circuz/TIFX11-FYP415-VT24-17/README.md

# TIFX11-FYP415-VT24-17
GitHub repository for bachelors thesis in physics on the collective behaviour of autonomous robots in a complex environment

# Required packages:
apriltag
cv2
pandas
numpy
pyqtgraph
