circuz/TIFX11-FYP415-VT24-17/3d_models/whole_robot.FCStd

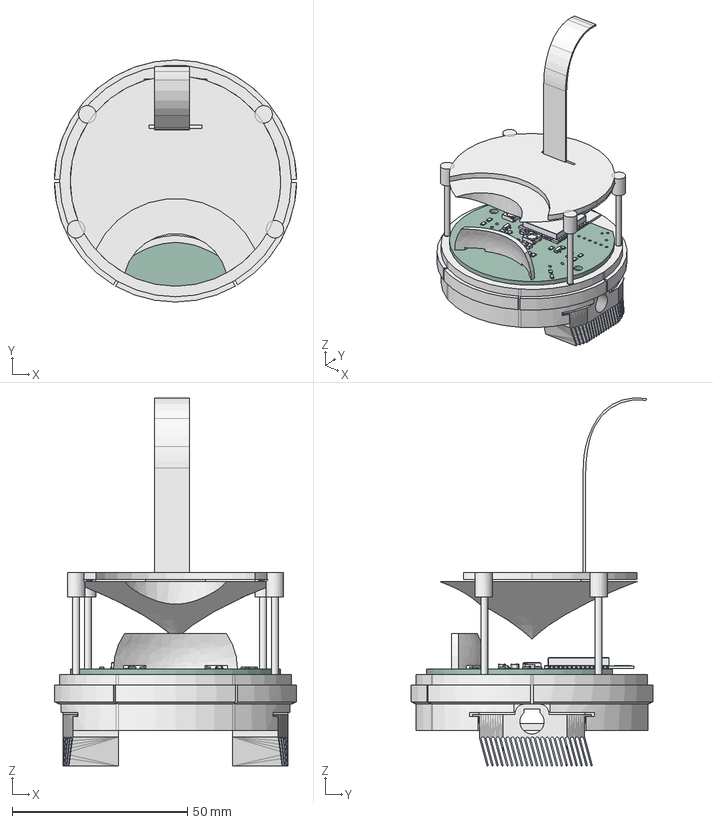
[picture p1: CAD file, 2024-05-06]
3d_models/whole_robot.FCStd
69.0 x 69.0 x 104.9 mm
Solid (Mirror #1)
R_0805_2012Metric
R_0805_2012Metric002
R_0805_2012Metric004
C_0805_2012Metric
R_0805_2012Metric006
R_0805_2012Metric008
R_0805_2012Metric010
R_0805_2012Metric012
R_0805_2012Metric014
R_0805_2012Metric016
L_0805_2012Metric
ESP32-WROOM-32
R_0805_2012Metric018
C_0805_2012Metric002
R_0805_2012Metric020
C_0805_2012Metric004
TSOT_23_6
R_0805_2012Metric022
R_0805_2012Metric024
R_0805_2012Metric026
SOT_23
R_0805_2012Metric028
SOT_024
LED_SK6812_PLCC4_50x50mm_P32mm
R_0805_2012Metric030
R_0805_2012Metric032
C_0805_2012Metric006
LED_SK6812_PLCC4_50x50mm_P32mm001
robot_pcb_PCB
Kon2
Hatt2
MainBody
