circuz/TIFX11-FYP415-VT24-17/3d_models/ready_to_print/cone.3mf

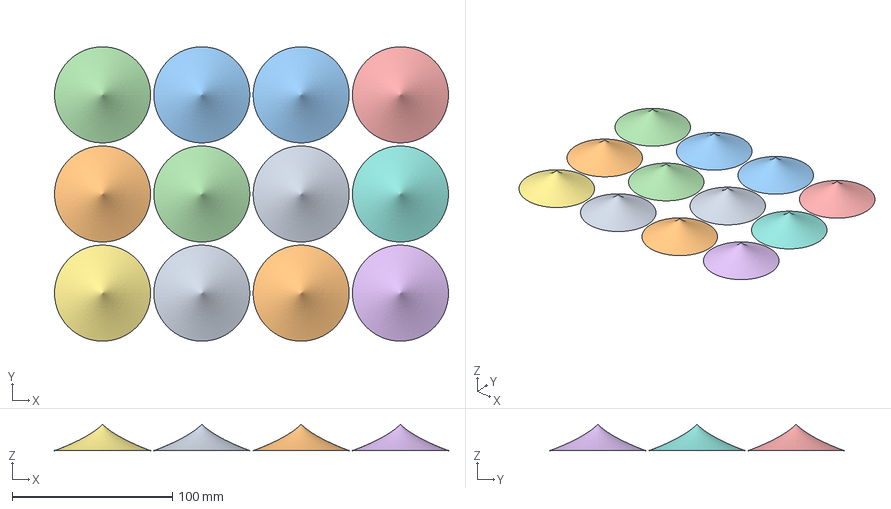
[picture p2: CAD file, 2024-05-06]
3d_models/ready_to_print/cone.3mf
246.0 x 183.7 x 16.5 mm
