circuz/TIFX11-FYP415-VT24-17/3d_models/ready_to_print/roof.3mf

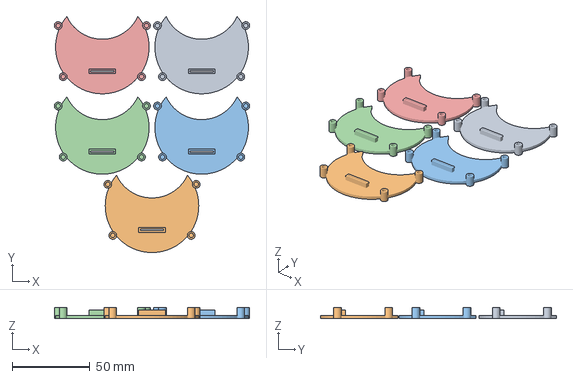
[picture p3: CAD file, 2024-05-06]
3d_models/ready_to_print/roof.3mf
125.4 x 151.3 x 7.00 mm
