circuz/TIFX11-FYP415-VT24-17/3d_models/ready_to_print/body.3mf

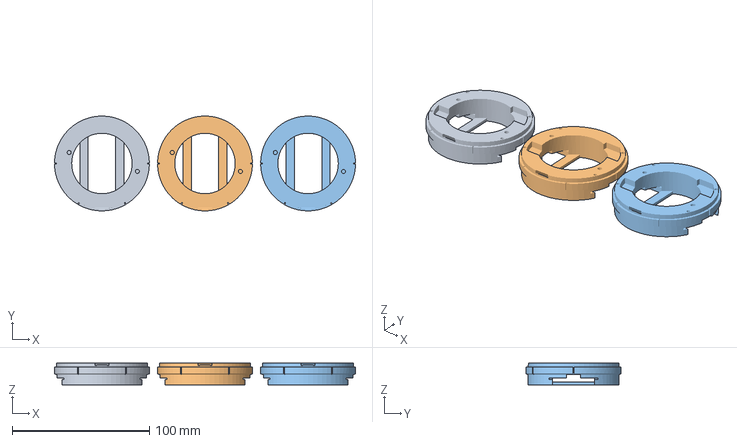
[picture p4: CAD file, 2024-05-06]
3d_models/ready_to_print/body.3mf
219.0 x 69.0 x 16.0 mm
