circuz/TIFX11-FYP415-VT24-17/3d_models/ready_to_print/parabol.3mf

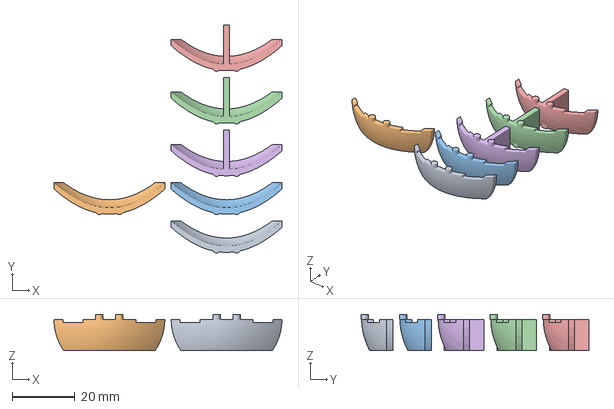
[picture p5: CAD file, 2024-05-06]
3d_models/ready_to_print/parabol.3mf
72.7 x 72.6 x 11.6 mm
parabol
parabol_split
