circuz/TIFX11-FYP415-VT24-17/3d_models/ready_to_print/foot.3mf

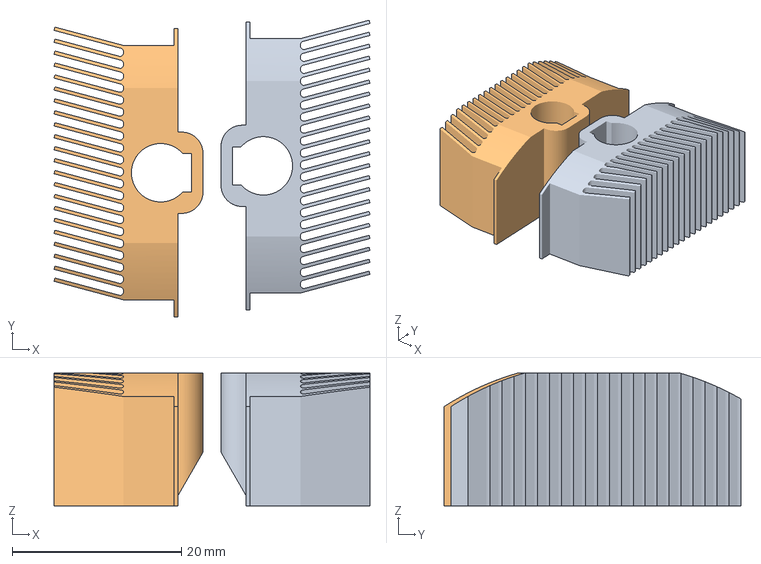
[picture p6: CAD file, 2024-05-06]
3d_models/ready_to_print/foot.3mf
37.3 x 35.0 x 15.7 mm
foot.stl x 2
