circuz/TIFX11-FYP415-VT24-17/pcb/robot_pcb.kicad_pcb

## KiCad design pcb/robot_pcb.kicad_pcb (2024-05-06)

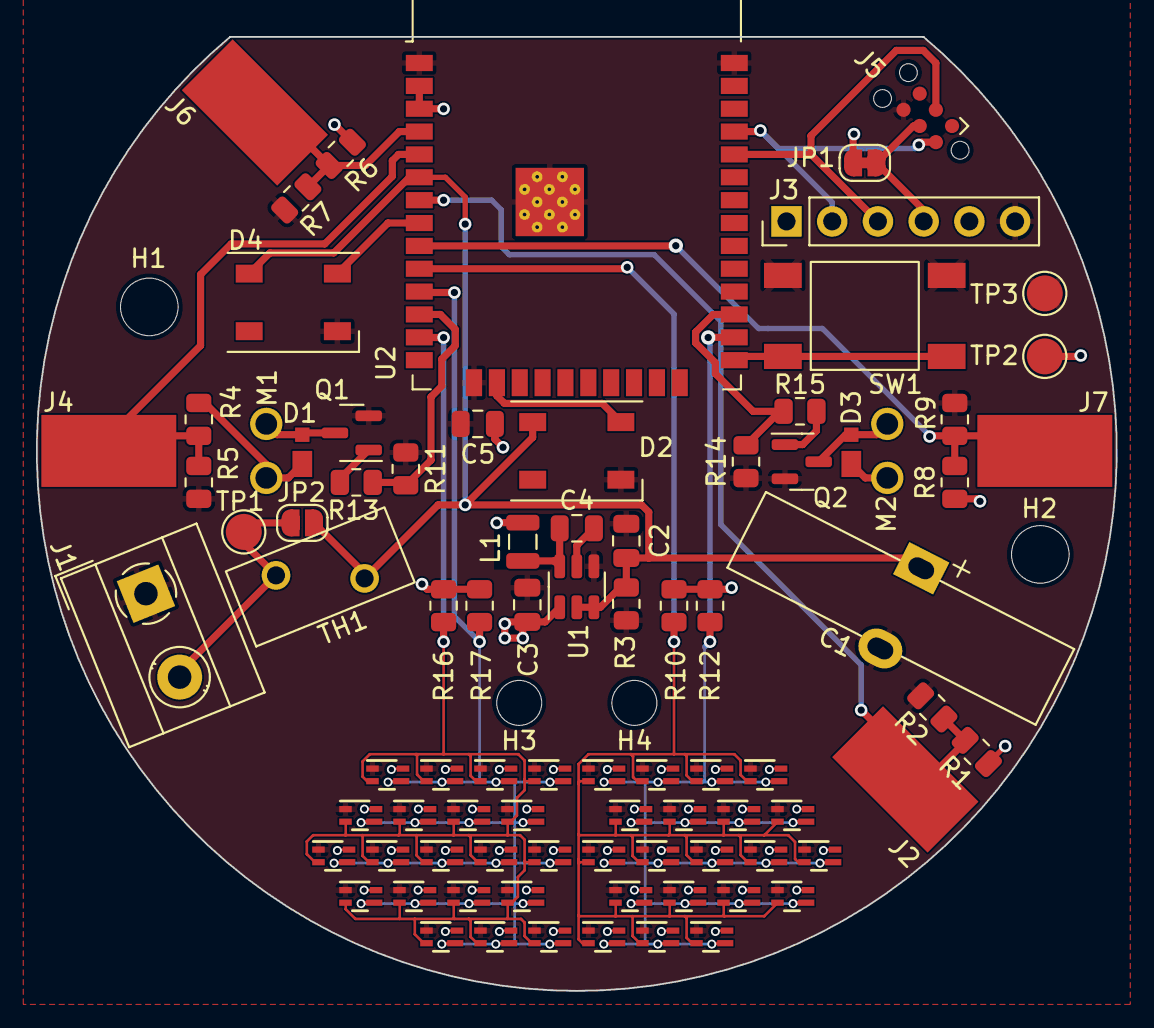
[picture p7: board robot_pcb.kicad_pcb from above]

Board: 2 copper layers, 60.0 x 53.0 mm, 91 parts (0 on the bottom side), 26 nets.

Parts:
C1: 1; DX_5R5VxxxxU_D19.0mm_P5.00mm
C2: 10u; C_0805_2012Metric
C3: 22u; C_0805_2012Metric
C4, C5: 100n; C_0805_2012Metric
D1, D3: D; PMDE_diode
D2: Coms LED; LED_SK6812_PLCC4_5.0x5.0mm_P3.2mm
D4: Status LED; LED_SK6812_PLCC4_5.0x5.0mm_P3.2mm
H1, H2: Mounting hole; MountingHole_3.2mm_M3
H3, H4: Lens alignment hole; MountingHole_2.5mm
J1: Power in; TerminalBlock_MetzConnect_Type055_RT01502HDWU_1x02_P5.00mm_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
J2: BUMPER1; 4x7.5 pad
J3: Programming header; PinHeader_1x06_P2.54mm_Vertical
J4: BUMPER2; 4x7.5 pad
J5: Tag-Connect header; Tag-Connect_TC2030-IDC-NL_2x03_P1.27mm_Vertical
J6: BUMPER3; 4x7.5 pad
J7: BUMPER4; 4x7.5 pad
JP1: Programmer power; SolderJumper-2_P1.3mm_Bridged_RoundedPad1.0x1.5mm
JP2: NTC bypass; SolderJumper-2_P1.3mm_Open_RoundedPad1.0x1.5mm
L1: 4.7u; L_0806_2016Metric
M1, M2: Vibration motor; motor 3932153
Q1, Q2: NMOS; SOT-23
R1, R2, R4, R5, R6, R7, R8, R9, R11, R14: 10k; R_0805_2012Metric
R3, R10, R12, R16, R17: 2.2k; R_0805_2012Metric
R13, R15: 100; R_0805_2012Metric
SW1: Boot Select; switch 2610956
TH1: 5; NTC_P5mm
TP1, TP2, TP3: TestPoint; TestPoint_Pad_D2.0mm
U1: AP63203WU; TSOT-23-6
U2: ESP32-WROOM-32E; ESP32-WROOM-32D
U3, U4, U5, U6, U7, U8, U9, U10, U11, U12, U13, U14, U15, U16, U17, U18, U19, U20, U21, U22, U23, U24, U25, U26, U27, U28, U29, U30, U31, U32, U33, U34, U35, U36, U37, U38, U39, U40, U41, U42: VEML3328; SMD_L3328_VIS_better

Connections:
+3V3: C3.1, C5.1, D1.1 (K), D3.1 (K), JP1.2 (B), L1.1, M1.1 (+), M2.1 (+), R1.1, R4.1, R6.1, R8.1, R10.1, R12.1, R16.1, R17.1, TP2.1, U1.1 (FB), U2.2 (VDD), U2.3 (EN), U3.4 (VDD), U4.4 (VDD), U5.4 (VDD), U6.4 (VDD), U7.4 (VDD), U8.4 (VDD), U9.4 (VDD), U10.4 (VDD), U11.4 (VDD), U12.4 (VDD), U13.4 (VDD), U14.4 (VDD), U15.4 (VDD), U16.4 (VDD), U17.4 (VDD), U18.4 (VDD), U19.4 (VDD), U20.4 (VDD), U21.4 (VDD), U22.4 (VDD), U23.4 (VDD), U24.4 (VDD), U25.4 (VDD), U26.4 (VDD), U27.4 (VDD), U28.4 (VDD), U29.4 (VDD), U30.4 (VDD), U31.4 (VDD), U32.4 (VDD), U33.4 (VDD), U34.4 (VDD), U35.4 (VDD), U36.4 (VDD), U37.4 (VDD), U38.4 (VDD), U39.4 (VDD), U40.4 (VDD), U41.4 (VDD), U42.4 (VDD)
BUMPER1: J2.1, R1.2, R2.1, U2.7 (IO35)
BUMPER2: J4.1, R4.2, R5.1, U2.5 (SENSOR_VN)
BUMPER3: J6.1, R6.2, R7.1, U2.4 (SENSOR_VP)
BUMPER4: J7.1, R8.2, R9.1, U2.9 (IO33)
COMS_LED_DATA: D2.2 (DIN), U2.16 (IO13)
GND: C1.2, C2.2, C3.2, C5.2, D2.1 (VSS), D4.1 (VSS), J1.1, J3.6, J5.6, Q1.2 (S), Q2.2 (S), R2.2, R3.2, R5.2, R7.2, R9.2, R11.1, R14.1, SW1.2, TP3.1, U1.4 (GND), U2.1 (GND), U2.15 (GND), U2.38 (GND), U2.39 (GND), U3.1 (GND), U4.1 (GND), U5.1 (GND), U6.1 (GND), U7.1 (GND), U8.1 (GND), U9.1 (GND), U10.1 (GND), U11.1 (GND), U12.1 (GND), U13.1 (GND), U14.1 (GND), U15.1 (GND), U16.1 (GND), U17.1 (GND), U18.1 (GND), U19.1 (GND), U20.1 (GND), U21.1 (GND), U22.1 (GND), U23.1 (GND), U24.1 (GND), U25.1 (GND), U26.1 (GND), U27.1 (GND), U28.1 (GND), U29.1 (GND), U30.1 (GND), U31.1 (GND), U32.1 (GND), U33.1 (GND), U34.1 (GND), U35.1 (GND), U36.1 (GND), U37.1 (GND), U38.1 (GND), U39.1 (GND), U40.1 (GND), U41.1 (GND), U42.1 (GND)
MOTOR1: R11.2, R13.1, U2.12 (IO27)
MOTOR2: R14.2, R15.1, U2.27 (IO16)
unnamed: D1.2 (A), M1.2 (-), Q1.3 (D)
unnamed: D3.2 (A), M2.2 (-), Q2.3 (D)
unnamed: J1.2, JP2.2 (B), TH1.1, TP1.1
unnamed: J3.4, J5.4, JP1.1 (A)
unnamed: Q1.1 (G), R13.2
unnamed: Q2.1 (G), R15.2
unnamed: C4.2, L1.2, U1.6 (BST)
unnamed: C4.1, U1.5 (SW)
unnamed: SW1.1, U2.25 (IO0)
PROG_RX: J3.2, J5.2, U2.35 (TXD0/IO1)
PROG_TX: J3.3, J5.3, U2.34 (RXD0/IO3)
SCL1: R12.2, U2.26 (IO4), U3.3 (SCL), U4.3 (SCL), U5.3 (SCL), U6.3 (SCL), U7.3 (SCL), U8.3 (SCL), U9.3 (SCL), U10.3 (SCL), U11.3 (SCL), U12.3 (SCL), U13.3 (SCL), U14.3 (SCL), U15.3 (SCL), U16.3 (SCL), U17.3 (SCL), U18.3 (SCL), U19.3 (SCL), U20.3 (SCL), U21.3 (SCL), U22.3 (SCL)
SCL2: R17.2, U2.11 (IO26), U23.3 (SCL), U24.3 (SCL), U25.3 (SCL), U26.3 (SCL), U27.3 (SCL), U28.3 (SCL), U29.3 (SCL), U30.3 (SCL), U31.3 (SCL), U32.3 (SCL), U33.3 (SCL), U34.3 (SCL), U35.3 (SCL), U36.3 (SCL), U37.3 (SCL), U38.3 (SCL), U39.3 (SCL), U40.3 (SCL), U41.3 (SCL), U42.3 (SCL)
SDA1: R10.2, U2.10 (IO25), U3.2 (SDA), U4.2 (SDA), U5.2 (SDA), U6.2 (SDA), U7.2 (SDA), U8.2 (SDA), U9.2 (SDA), U10.2 (SDA), U11.2 (SDA), U12.2 (SDA), U13.2 (SDA), U14.2 (SDA), U15.2 (SDA), U16.2 (SDA), U17.2 (SDA), U18.2 (SDA), U19.2 (SDA), U20.2 (SDA), U21.2 (SDA), U22.2 (SDA)
SDA2: R16.2, U2.13 (IO14), U23.2 (SDA), U24.2 (SDA), U25.2 (SDA), U26.2 (SDA), U27.2 (SDA), U28.2 (SDA), U29.2 (SDA), U30.2 (SDA), U31.2 (SDA), U32.2 (SDA), U33.2 (SDA), U34.2 (SDA), U35.2 (SDA), U36.2 (SDA), U37.2 (SDA), U38.2 (SDA), U39.2 (SDA), U40.2 (SDA), U41.2 (SDA), U42.2 (SDA)
STATUS_LED_DATA: D4.2 (DIN), U2.8 (IO32)
VCC: C1.1, C2.1, D2.3 (VDD), D4.3 (VDD), JP2.1 (A), R3.1, TH1.2, U1.2 (EN), U1.3 (IN), U2.6 (IO34)
