circuz/TIFX11-FYP415-VT24-17/(commit log)

2024-03-20 started working on pandas data frame
2024-04-14 new file: "RandomWalk/M\303\244tningar/14_apr_1.csv" new file: "RandomWalk/M\303\244tningar/tolkning_m\303\244tdata.py"
    [14_apr_1.csv]
2024-04-17 Uppdaterat tolkning_mätdata.py för att hantera det nya formatet hos mätdatan.
    [16_apr_1.csv]
2024-04-23 Lagt in mätdata RandomWalk
    [2024-04-21 12:03:04.036995.csv, 2024-04-21 12:11:07.551996.csv, 2024-04-21 12:20:58.492370.csv, 2024-04-21 12:39:16.325104.csv, 2024-04-21 12:47:22.319191.csv, 2024-04-21 12:56:05.476461.csv, 2024-04-21 13:04:29.146581.csv, 2024-04-21 13:12:18.439243.csv]
2024-04-23 Lagt till levande-kristall-tolknign av mätdatan
    [2024-04-21 12:11:07.551996.csv]
2024-05-06 3d models
    [body.3mf, cone.3mf, foot.3mf, parabol.3mf, roof.3mf, whole_robot.FCStd]
2024-05-06 pcb files
    [color_sensor.kicad_sch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]
